BeardVis/tiamat-voron-2/(list of files, cad)

Other CAD files:
CAD/aht30_mount.f3d
CAD/cable_trunking.f3d
CAD/cable_trunking_host_adapter.f3d
CAD/can_cable_ptfe_clip.f3d
CAD/lrs_350_ps_din_clip.f3d
CAD/manta_m8p_din_clip_front.f3d
CAD/manta_m8p_v2_0_din_clip_back.f3d
CAD/powersupply_side_support.f3d
CAD/sfs_mount.f3d
CAD/umbilical_mount.f3d
CAD/z_belt_clip.f3d
CAD/z_belt_cover_panel_support.f3d
