BeardVis/tiamat-voron-2/config/head_status.cfg

[gcode_macro _KNOMI_STATUS]
variable_homing: False
variable_probing: False
variable_qgling: False
variable_heating_nozzle: False
variable_heating_bed: False
gcode:

[gcode_macro M109]
rename_existing: M109.1
gcode:
  STATUS_HEATING
  SET_GCODE_VARIABLE MACRO=_KNOMI_STATUS VARIABLE=heating_nozzle VALUE=True
  M109.1 {rawparams}
  STATUS_READY
  SET_GCODE_VARIABLE MACRO=_KNOMI_STATUS VARIABLE=heating_nozzle VALUE=False

[gcode_macro M190]
rename_existing: M190.1
gcode:
  STATUS_HEATING
  SET_GCODE_VARIABLE MACRO=_KNOMI_STATUS VARIABLE=heating_bed VALUE=True
  M190.1 {rawparams}
  STATUS_READY
  SET_GCODE_VARIABLE MACRO=_KNOMI_STATUS VARIABLE=heating_bed VALUE=False

[gcode_macro BED_MESH_CALIBRATE]
rename_existing: BTT_BED_MESH_CALIBRATE
gcode:
  STATUS_MESHING
  SET_GCODE_VARIABLE MACRO=_KNOMI_STATUS VARIABLE=probing VALUE=True
  BTT_BED_MESH_CALIBRATE {rawparams}
  STATUS_READY
  SET_GCODE_VARIABLE MACRO=_KNOMI_STATUS VARIABLE=probing VALUE=False

[gcode_macro QUAD_GANTRY_LEVEL]
rename_existing: BTT_QUAD_GANTRY_LEVEL
gcode:
  STATUS_LEVELING
  SET_GCODE_VARIABLE MACRO=_KNOMI_STATUS VARIABLE=qgling VALUE=True
  BTT_QUAD_GANTRY_LEVEL {rawparams}
  STATUS_READY
  SET_GCODE_VARIABLE MACRO=_KNOMI_STATUS VARIABLE=qgling VALUE=False
