BeardVis/tiamat-voron-2/(notices)

Notices in the files:
README.md:
License: GPLv3
